moongaze/v2.4_Hinge_mod/README.md

# Voron v2.4 Side-Slide Hinges

## v2.4 300mm BOM:
- [4mm rods](https://www.aliexpress.com/item/32297671032.html?spm=2114.13010708.0.0.3a994c4dbA1iDS) (2 x 41mm)
- 6mm rods (4 x 448mm) 
- 4x [LM6UU linear bearing](https://www.aliexpress.com/item/32815449673.html?spm=a2g0s.8937460.0.0.12852e0eL5v9BS) (6mm ID, 12mm OD, 19mm length) 
- 4x [HK0408 needle bearing](https://www.aliexpress.com/item/4000273016481.html?spm=2114.13010708.0.0.3a994c4dbA1iDS)

- 8x M3x16 sockethead
- 8x M3 T-nuts
- 4x M3x10 or m3x12 sockethead (To secure the door ; This depends on the thickness of your panel)
- 4x M3 hex nuts (To secure the door)
- 4x M3 washer (To secure the door)

## Info:

**The print parts are intended for PLA** (ABS shrink is not accounted for), and a **total panel thickness of 6mm**. This includes the foam gasket.
So different configurations are possible e.g. 4mm door panel + 2mm foam, or 3mm door panel + 3mm foam.
I intentionally undersized the parts touching the panels by 0.3mm to compress the foam and ensure airtightness.

**The STL files are for a right side mount**

**For a left side mount and alternate versions check the CAD files**

To insert the LM6UU bearings, I've used a small hammer. It's a tight fit. YMMV.

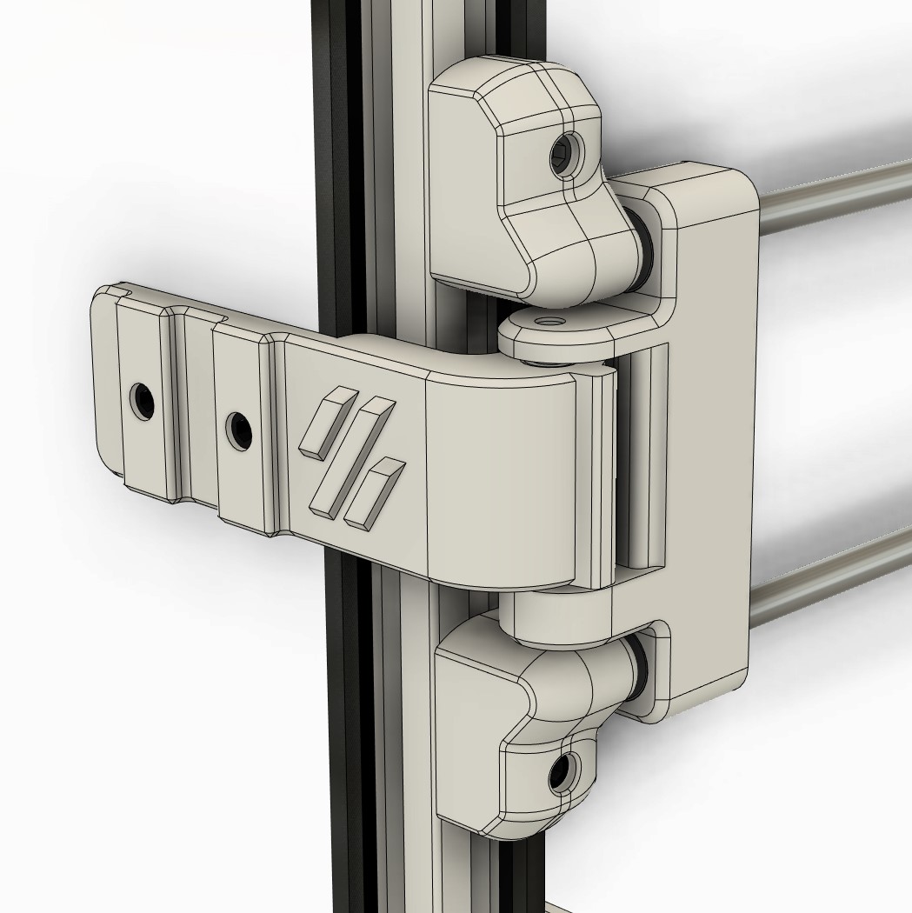
[picture p1: Photos/CADview_02.jpg]

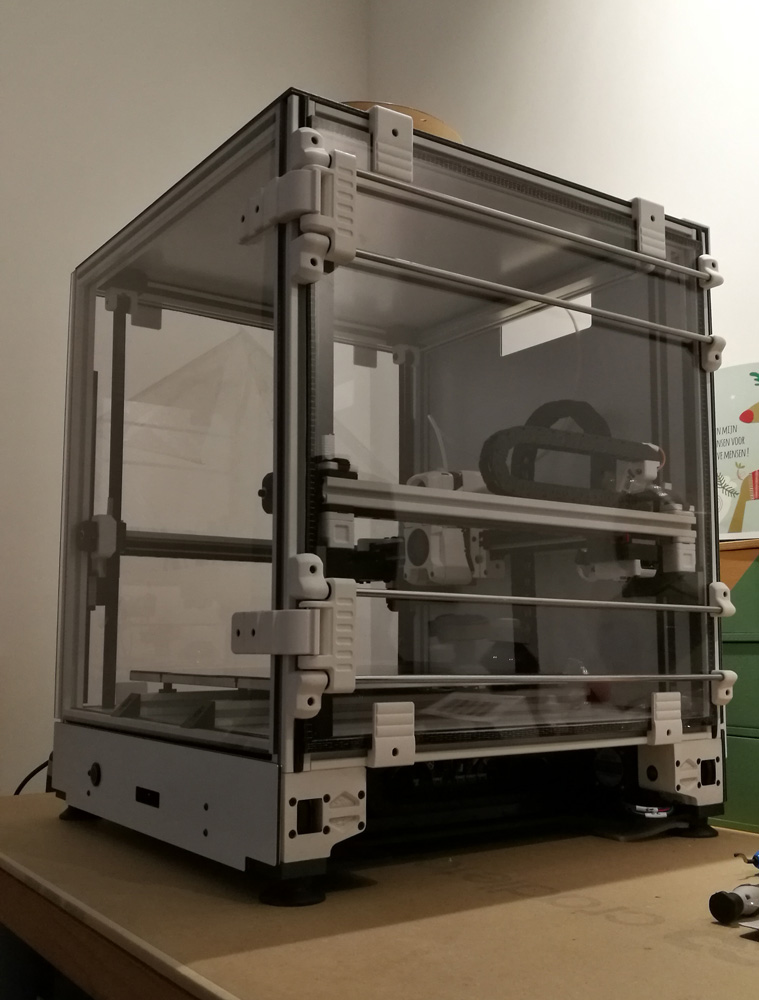
[picture p2: Photos/mOOngaze_Hinge_Closed.jpg]

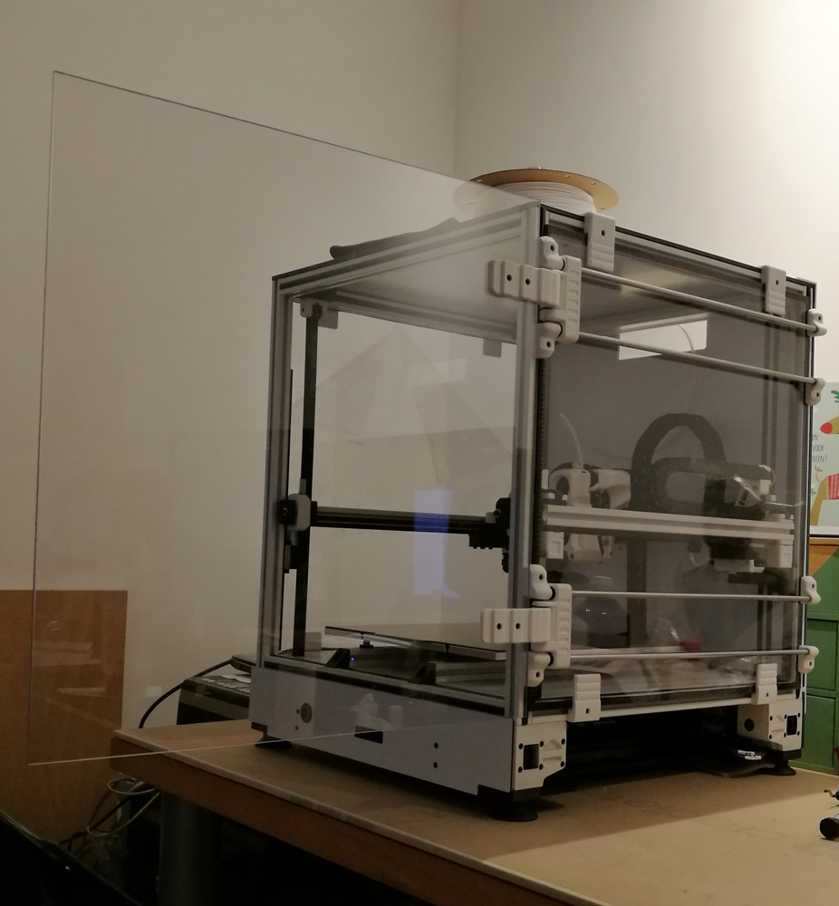
[picture p3: Photos/mOOngaze_Hinge_Open.jpg]

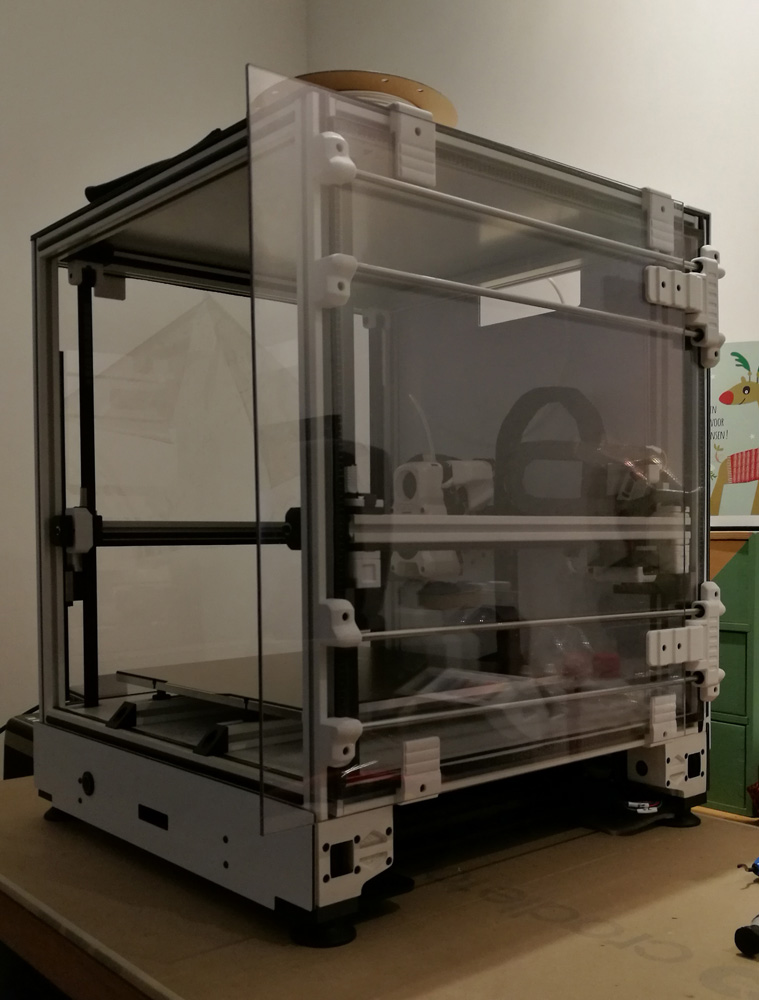
[picture p4: Photos/mOOngaze_Hinge_Parked.jpg]
