moongaze/v2.4_Hinge_mod/Photos/CADview_01.jpg

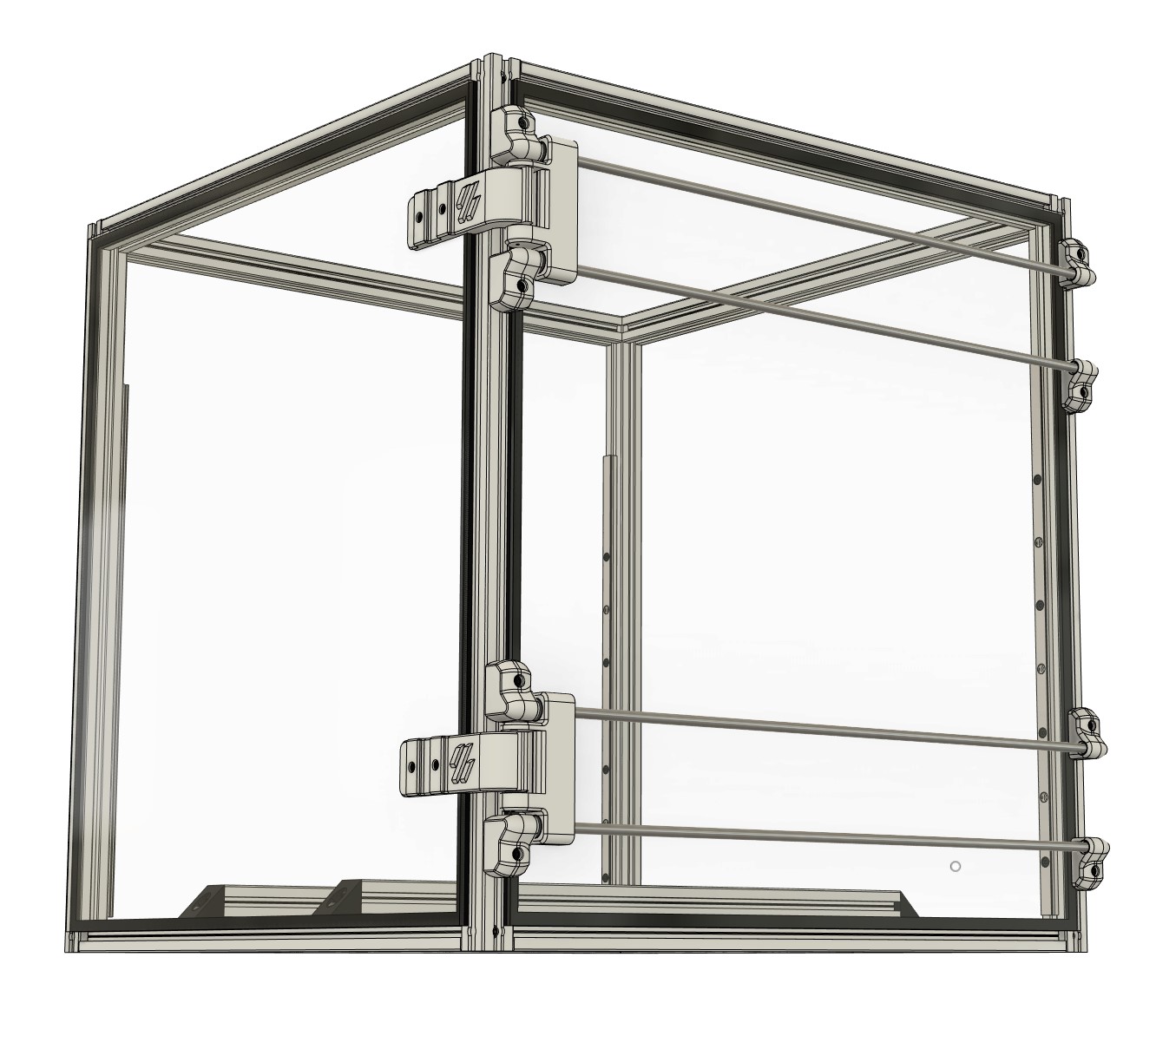
Photos/CADview_01.jpg
