moongaze/v2.4_Hinge_mod/Photos/mOOngaze_Hinge_CloseUp.jpg

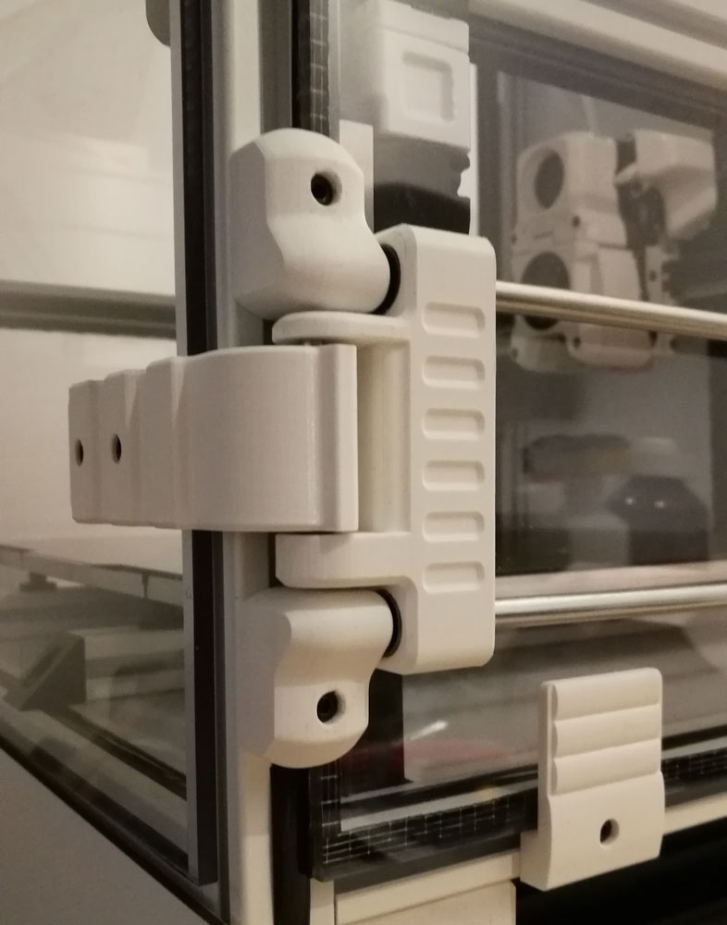
Photos/mOOngaze_Hinge_CloseUp.jpg
