moongaze/v2.4_Hinge_mod/STL/mOOngaze_Hinge_RodHanger V3_Right_Mount_MGNZ.stl

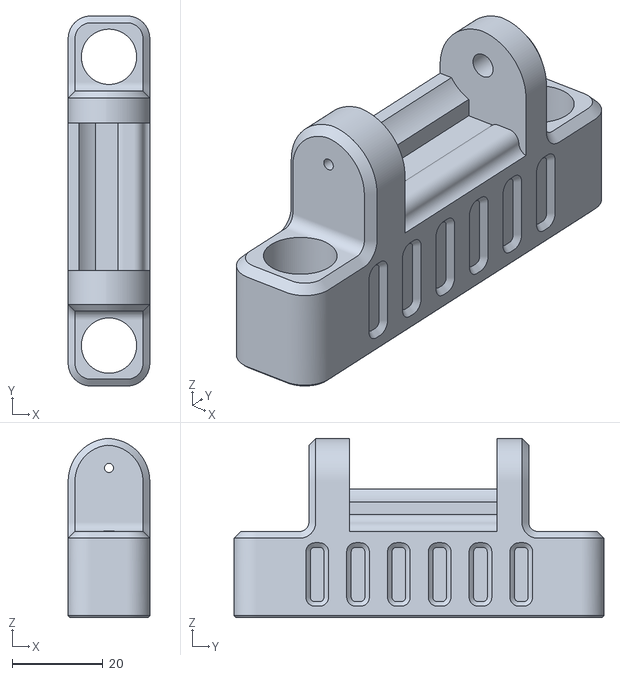
[picture p7: CAD file, 2024-11-12]
STL/mOOngaze_Hinge_RodHanger V3_Right_Mount_MGNZ.stl
18.0 x 81.6 x 39.5
