moongaze/v2.4_Hinge_mod/STL/mOOngaze_Hinge_Door_v2_x2.stl

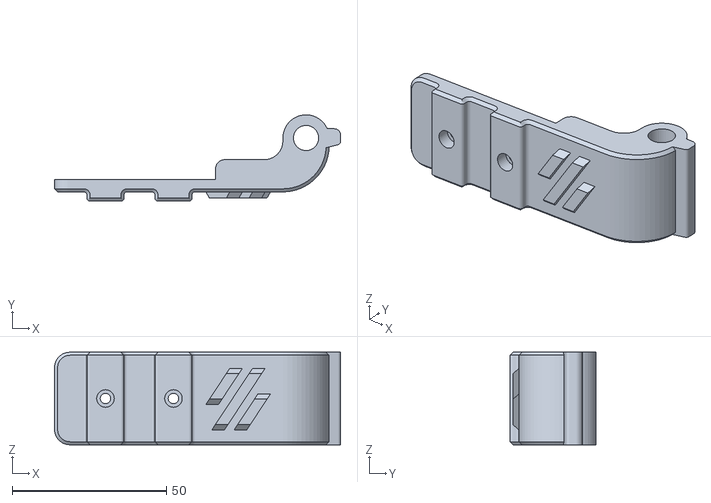
[picture p8: CAD file, 2021-04-02]
STL/mOOngaze_Hinge_Door_v2_x2.stl
92.6 x 27.9 x 30.0
