moongaze/v2.4_Hinge_mod/STL/mOOngaze_Hinge_RodHolder_B_x4.stl

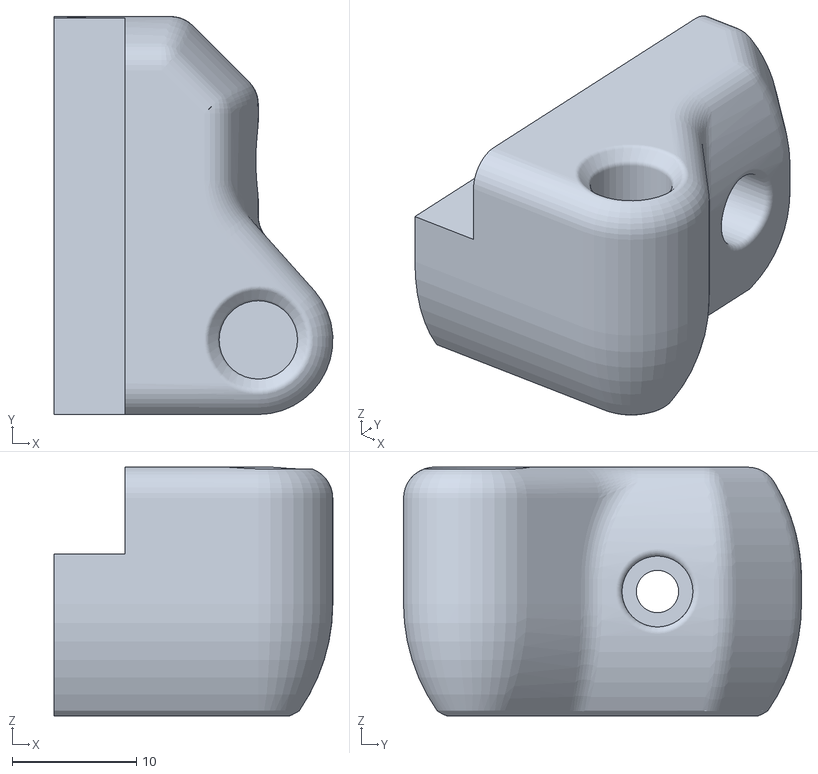
[picture p9: CAD file, 2021-02-09]
STL/mOOngaze_Hinge_RodHolder_B_x4.stl
22.4 x 32.0 x 20.0
