moongaze/v2.4_Hinge_mod/(list of files, cad)

Other CAD files:
STL/mOOngaze_Hinge_RodHanger V3_Right_Mount.stl
STL/mOOngaze_Hinge_RodHolder_A_x4.stl
