moongaze/v2.4_Hinge_mod/(commit log)

2021-02-09 Add files via upload
    Sliding Door by mOOngaze#5007
    Tested on my v2.4
    v2.4 300mm BOM:
    - 4mm rods (2 x 41mm)
    - 6mm rods (4 x 448mm)
    - 4x LM6UU linear bearing (6mm ID, 12mm OD, 19mm length)
    - 4x HK0408 needle bearing
    - 8x M3x16 sockethead
    - 8x M3 T-nuts
    - 4x M3x10 or m3x12 sockethead (To secure the door ; This depends on the thickness of your panel)
    - 4x M3 hex nuts (To secure the door)
    - 4x M3 washer (To secure the door)
    The print parts are intended for PLA (ABS shrink not accounted for), and a total panel thickness of 6mm. This includes the foam gasket.
    So different configurations are possible e.g. 4mm door panel + 2mm foam, or 3mm door panel + 3mm foam.
    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
    [mOOngaze_Hinge_Door_(NoFoamGasket)_x2.stl, mOOngaze_Hinge_Door_x2.stl, mOOngaze_Hinge_RodHanger_x2.stl, mOOngaze_Hinge_RodHolder_A_(NoFoamGasket)_x4.stl, mOOngaze_Hinge_RodHolder_A_x4.stl, mOOngaze_Hinge_RodHolder_B_(NoFoamGasket)_x4.stl, mOOngaze_Hinge_RodHolder_B_x4.stl]
2021-04-02 Add files via upload
    Modified soft lock so the hinge stays in place better when open
    [mOOngaze_Hinge_Door_v2_x2.stl]
2021-04-02 Add files via upload
    Modified soft lock to stay in place better when door is open
    [mOOngaze_Hinge_RodHanger(LM)_x2.stl, mOOngaze_Hinge_RodHanger(RM)_x2.stl]
2021-04-02 Add files via upload
    put in print position
    [mOOngaze_Hinge_RodHanger(LM)_x2.stl, mOOngaze_Hinge_RodHanger(RM)_x2.stl]
2024-09-30 Add files via upload
    Thicker and Stronger re-inforced version.
    Recommended for the top hinge at least
    [Hinge_RodHanger V4.stl]
2024-09-30 Update and rename
    [Hinge_RodHanger_Re-inforced_x2.stl]
2024-09-30 Add files via upload
    Stronger re-inforced version
    [Hinge_RodHanger V4.stl]
2024-11-12 Delete STL/mOOngaze_Hinge_RodHanger(LM)_x2.stl
    weak version that tended to break
    [mOOngaze_Hinge_RodHanger(LM)_x2.stl]
2024-11-12 Delete STL/mOOngaze_Hinge_RodHanger(RM)_x2.stl
    weak version
    [mOOngaze_Hinge_RodHanger(RM)_x2.stl]
